Jugendhackt/Badge-2022/(commit log)

2022-08-27 chore: initial commit
    [JugendHackt-Badge-Display.kicad_pcb, JugendHackt-Badge-Display.kicad_sch]
2022-08-31 feat: Finalize SCH, changes in PCB
    [JugendHackt-Badge-Display.kicad_pcb, JugendHackt-Badge-Display.kicad_sch]
2022-09-01 feat: Finalize PCB & SCH
    [JugendHackt-Badge-Display.kicad_pcb, JugendHackt-Badge-Display.kicad_sch]
2022-09-02 moved IR transmitter
    [JugendHackt-Badge-Display.kicad_pcb]
2022-09-02 moved IR transmitter resistor
    [JugendHackt-Badge-Display.kicad_pcb]
2022-09-02 placed LEDs
    [JugendHackt-Badge-Display.kicad_pcb]
2022-09-02 fixed silkscreen
    [JugendHackt-Badge-Display.kicad_pcb]
2022-09-02 changed IO layout
    [JugendHackt-Badge-Display.kicad_sch]
2022-09-02 updated IO layout in schematic
    [JugendHackt-Badge-Display.kicad_pcb]
2022-09-02 routed LEDs
    [JugendHackt-Badge-Display.kicad_pcb]
2022-09-02 routed ir tx
    [JugendHackt-Badge-Display.kicad_pcb]
2022-09-02 feat: finalized PCB
    [JugendHackt-Badge-Display.kicad_pcb, JugendHackt-Badge-Display.kicad_sch]
2022-09-06 feat: Final PCB
    [JugendHackt-Badge-Display.kicad_pcb, JugendHackt-Badge-Display.kicad_sch]
